xunil/wave_light_lp5569/wave_light_lp5569.png

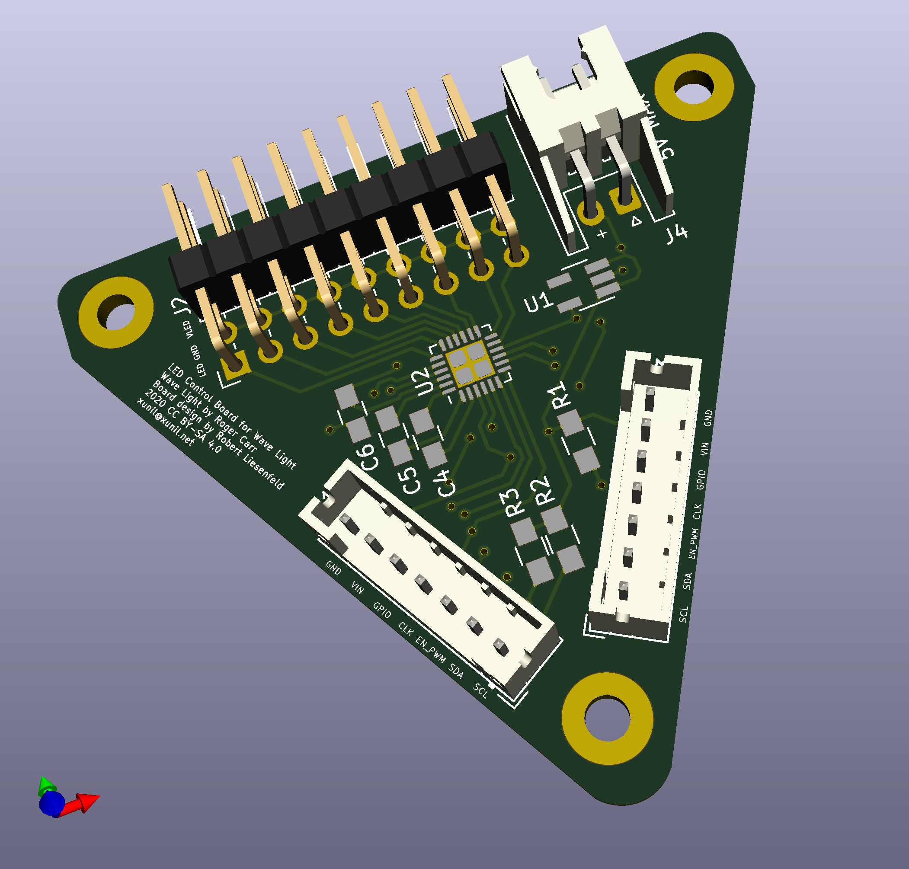
wave_light_lp5569.png
