xunil/wave_light_lp5569/wave_light_lp5569.pdf

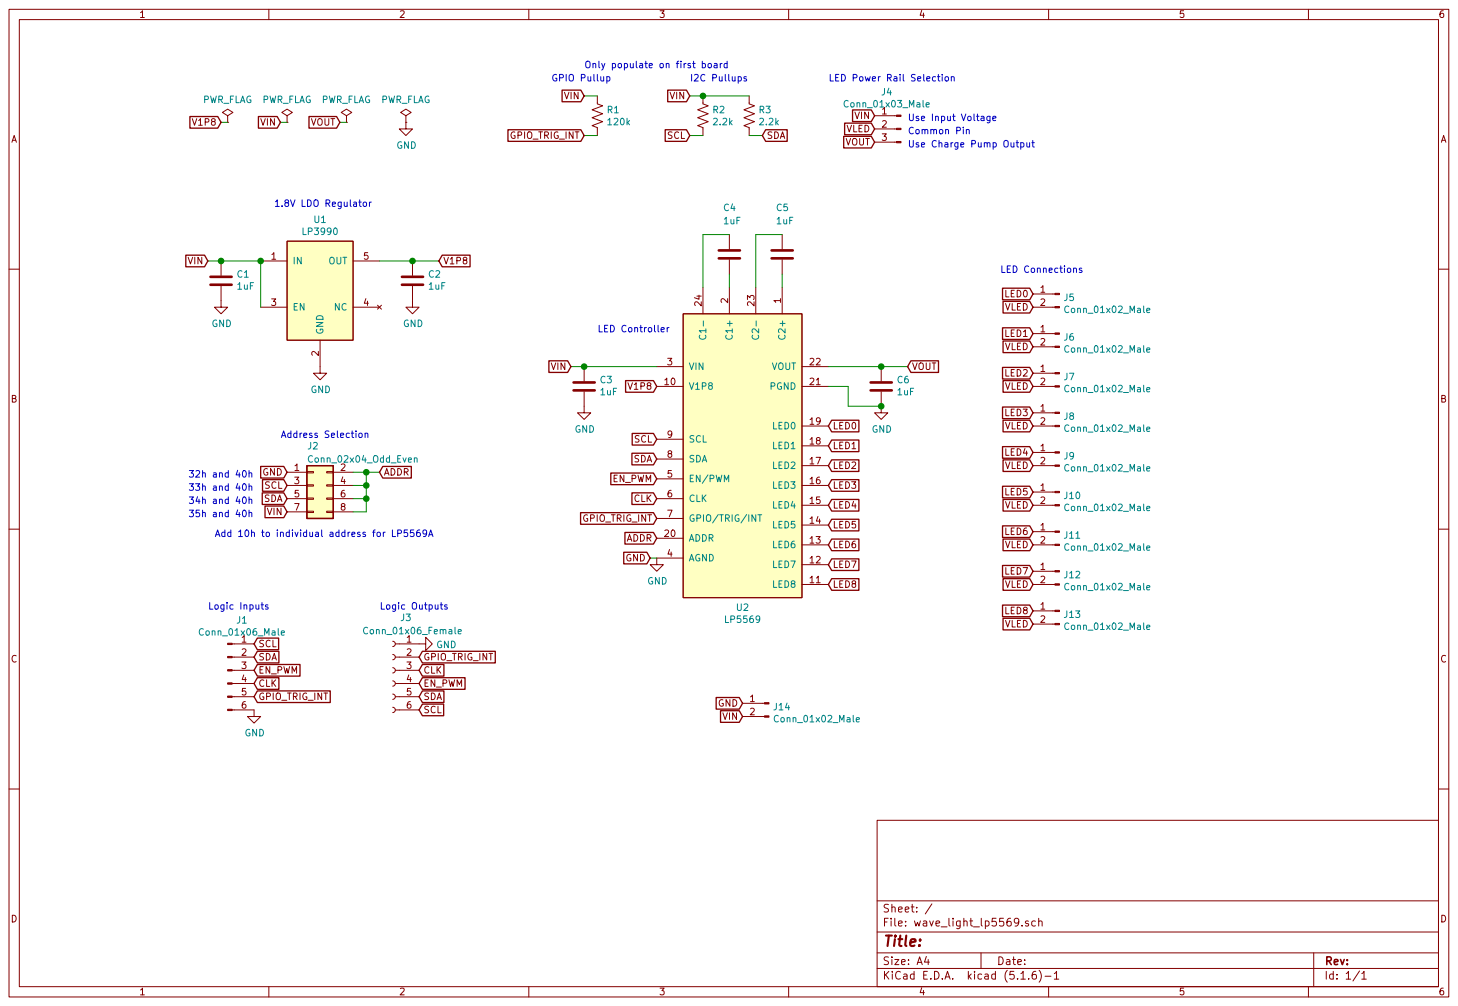
[picture p2: page 1]

1.8V LDO Regulator Address Selection

VOUT VIN
Use Charge Pump Output LED Controller 35h and 40h

Common Pin Use Input Voltage

2 ADDR 20 PGND 21 VOUT 22 C2- 23 C1- 24 VIN 3 AGND 4 EN/PWM 5 CLK 6 GPIO/TRIG/INT 7 SDA 8 SCL 9 U2
