xunil/wave_light_lp5569/wave_light_lp5569.kicad_pcb

## KiCad design wave_light_lp5569.kicad_pcb (2021-01-07)

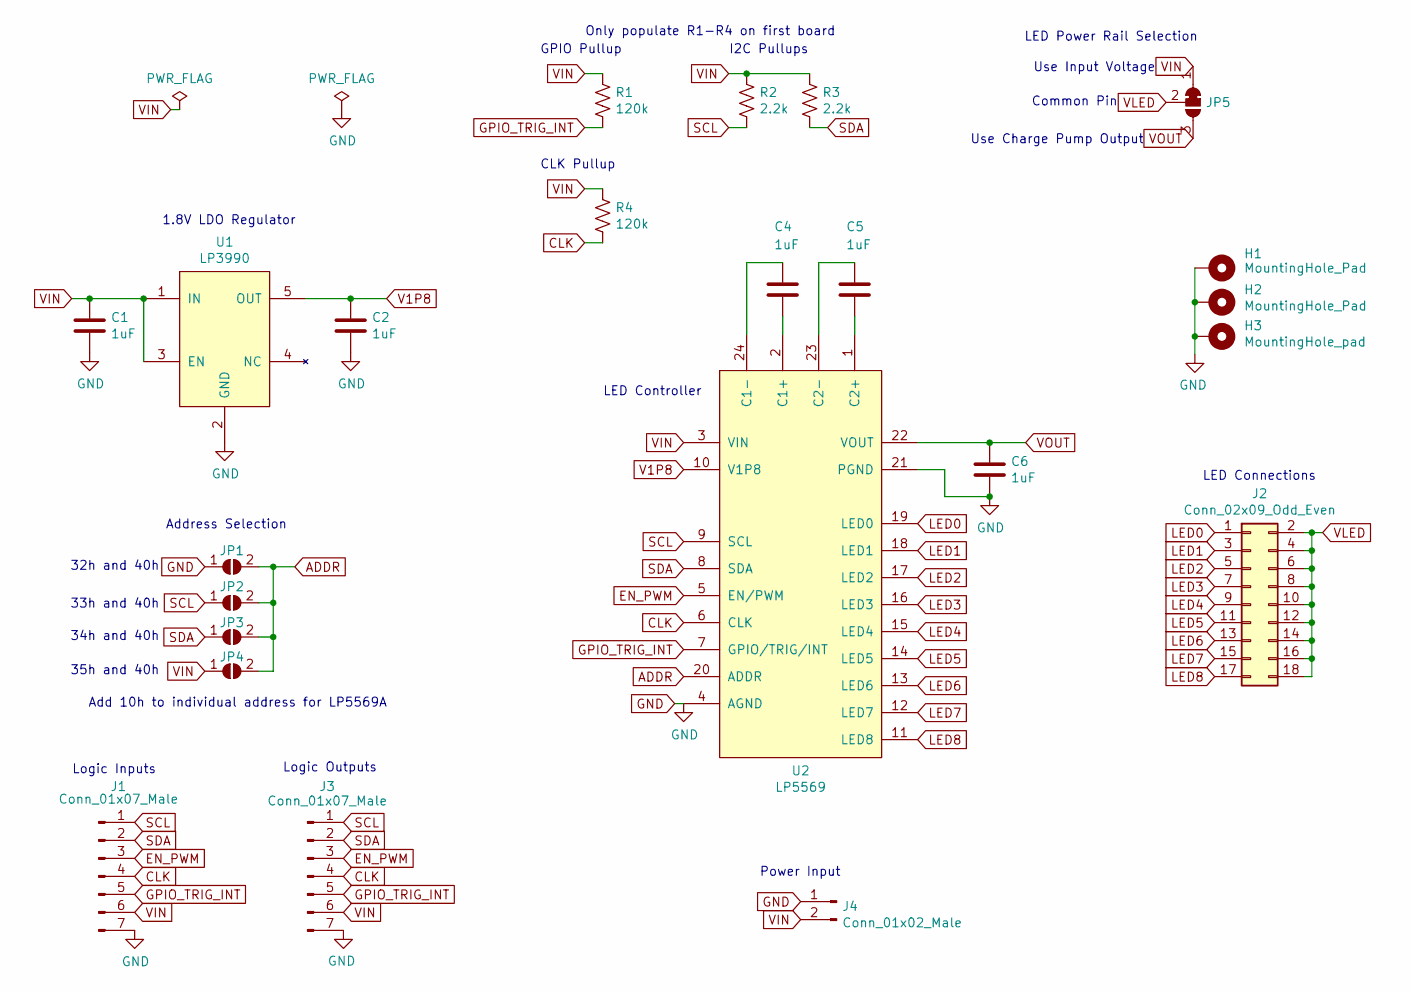
[picture p3: schematic wave_light_lp5569.sch]

Parts:
C1, C2, C4, C5, C6: 1uF; C_0805_2012Metric
H1, H2: MountingHole_Pad; MountingHole_2.7mm_Pad
H3: MountingHole_pad; MountingHole_2.7mm_Pad
J1, J3: Conn_01x07_Male; JST_PH_B7B-PH-K_1x07_P2.00mm_Vertical
J2: Conn_02x09_Odd_Even; PinHeader_2x09_P2.54mm_Horizontal
J4: Conn_01x02_Male; JST_XH_S2B-XH-A_1x02_P2.50mm_Horizontal
JP1, JP2, JP3, JP4: SolderJumper_2_Open; SolderJumper-2_P1.3mm_Open_RoundedPad1.0x1.5mm
JP5: SolderJumper_3_Bridged12; SolderJumper-3_P1.3mm_Bridged12_RoundedPad1.0x1.5mm
R1, R4: 120k; R_0805_2012Metric
R2, R3: 2.2k; R_0805_2012Metric
U1: LP3990; SOT-23-5
U2: LP5569; WQFN-24-1EP_4x4mm_P0.5mm_EP2.6x2.6mm

Connections:
ADDR: JP1.2 (B), JP2.2 (B), JP3.2 (B), JP4.2 (B), U2.20 (ADDR)
CLK: J1.4, J3.4, R4.2, U2.6 (CLK)
EN_PWM: J1.3, J3.3, U2.5 (EN/PWM)
GND: C1.1, C2.1, C6.1, H1.1, H2.1, H3.1, J1.7, J3.7, J4.1, JP1.1 (A), U1.2 (GND), U2.4 (AGND), U2.21 (PGND)
GPIO_TRIG_INT: J1.5, J3.5, R1.2, U2.7 (GPIO/TRIG/INT)
LED0: J2.1, U2.19 (LED0)
LED1: J2.3, U2.18 (LED1)
LED2: J2.5, U2.17 (LED2)
LED3: J2.7, U2.16 (LED3)
LED4: J2.9, U2.15 (LED4)
LED5: J2.11, U2.14 (LED5)
LED6: J2.13, U2.13 (LED6)
LED7: J2.15, U2.12 (LED7)
LED8: J2.17, U2.11 (LED8)
unnamed: C4.1, U2.2 (C1+)
unnamed: C4.2, U2.24 (C1-)
unnamed: C5.1, U2.1 (C2+)
unnamed: C5.2, U2.23 (C2-)
SCL: J1.1, J3.1, JP2.1 (A), R2.2, U2.9 (SCL)
SDA: J1.2, J3.2, JP3.1 (A), R3.2, U2.8 (SDA)
V1P8: C2.2, U1.5 (OUT), U2.10 (V1P8)
VIN: C1.2, J1.6, J3.6, J4.2, JP4.1 (A), JP5.1 (A), R1.1, R2.1, R3.1, R4.1, U1.1 (IN), U1.3 (EN), U2.3 (VIN)
VLED: J2.2, J2.4, J2.6, J2.8, J2.10, J2.12, J2.14, J2.16, J2.18, JP5.2 (C)
VOUT: C6.2, JP5.3 (B), U2.22 (VOUT)

Notes on the sheet:
1.8V LDO Regulator
Address Selection
Logic Inputs
LED Power Rail Selection
LED Connections
Logic Outputs
I2C Pullups
GPIO Pullup
Only populate R1-R4 on first board
32h and 40h
33h and 40h
34h and 40h
35h and 40h
Add 10h to individual address for LP5569A
LED Controller
Use Charge Pump Output
Use Input Voltage
Common Pin
Power Input
CLK Pullup

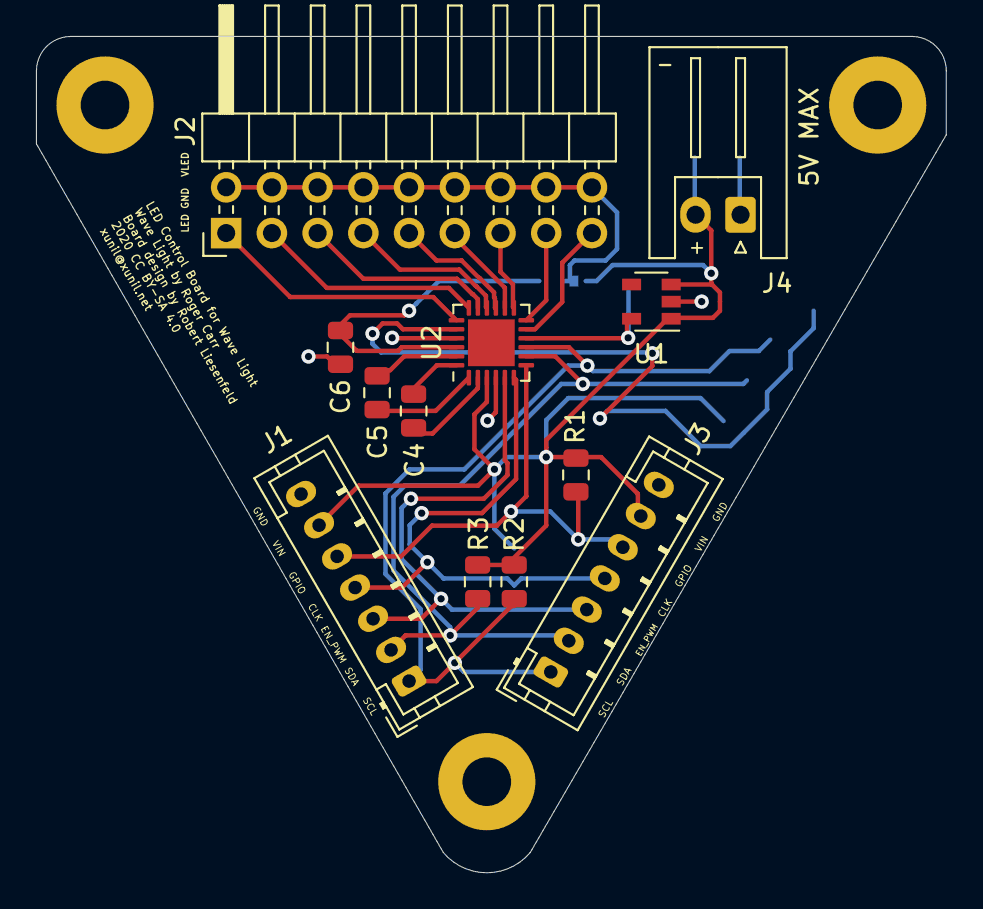
[picture p4: board wave_light_lp5569.kicad_pcb from above]

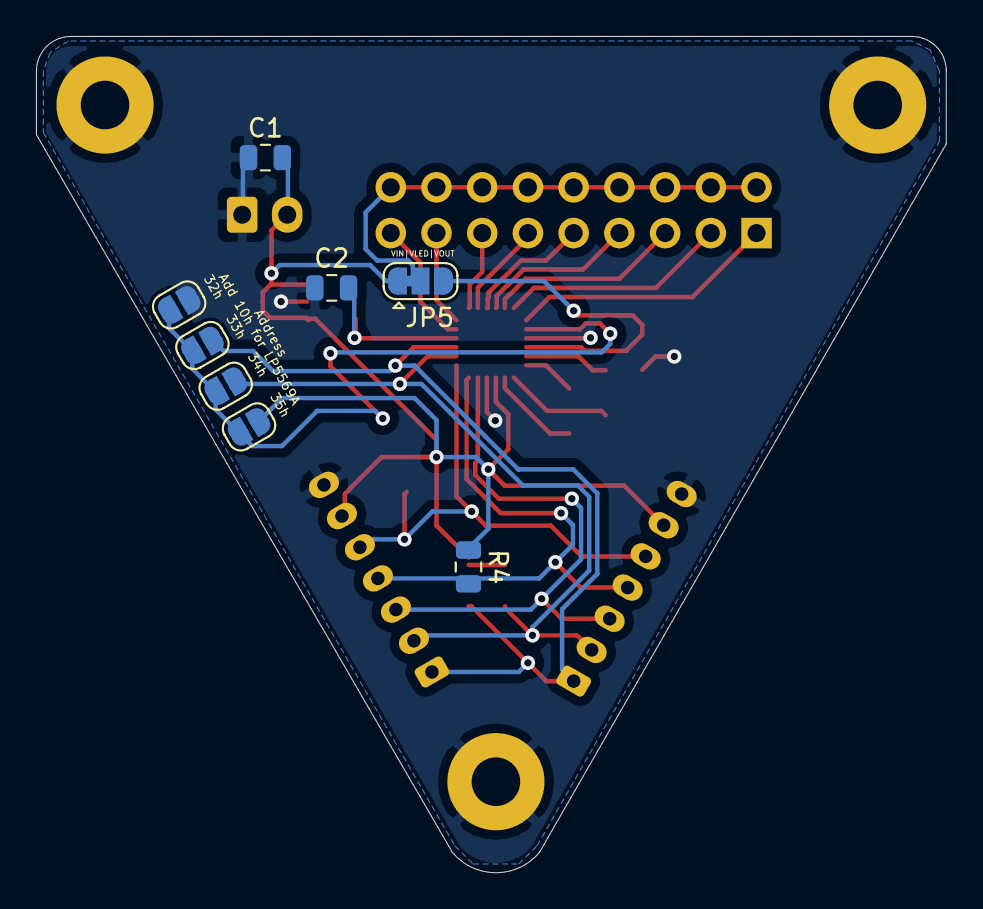
[picture p5: board wave_light_lp5569.kicad_pcb from below]

Board: 2 copper layers, 50.5 x 46.5 mm, 23 parts (8 on the bottom side), 24 nets.
