xunil/wave_light_lp5569/constants.py

# GPIO pin numbers
EN_PWM_GPIO_PIN = 4

# Registers
CONFIG = 0x0
LED_ENGINE_CONTROL1 = 0x1
LED_ENGINE_CONTROL2 = 0x2
LED0_CONTROL = 0x7
LED1_CONTROL = 0x8
LED2_CONTROL = 0x9
LED3_CONTROL = 0xA
LED4_CONTROL = 0xB
LED5_CONTROL = 0xC
LED6_CONTROL = 0xD
LED7_CONTROL = 0xE
LED8_CONTROL = 0xF
LED0_PWM = 0x16
LED1_PWM = 0x17
LED2_PWM = 0x18
LED3_PWM = 0x19
LED4_PWM = 0x1A
LED5_PWM = 0x1B
LED6_PWM = 0x1C
LED7_PWM = 0x1D
LED8_PWM = 0x1E
LED0_CURRENT = 0x22
LED1_CURRENT = 0x23
LED2_CURRENT = 0x24
LED3_CURRENT = 0x25
LED4_CURRENT = 0x26
LED5_CURRENT = 0x27
LED6_CURRENT = 0x28
LED7_CURRENT = 0x29
LED8_CURRENT = 0x2A
MISC = 0x2F
ENGINE1_PC = 0x30
ENGINE2_PC = 0x31
ENGINE3_PC = 0x32
MISC2 = 0x33
ENGINE_STATUS = 0x3C
IO_CONTROL = 0x3D
VARIABLE_D = 0x3E
RESET = 0x3F
ENGINE1_VARIABLE_A = 0x42
ENGINE2_VARIABLE_A = 0x43
ENGINE3_VARIABLE_A = 0x44
MASTER_FADER1 = 0x46
MASTER_FADER2 = 0x47
MASTER_FADER3 = 0x48
MASTER_FADER_PWM = 0x4A
ENGINE1_PROG_START = 0x4B
ENGINE2_PROG_START = 0x4C
ENGINE3_PROG_START = 0x4D
PROG_MEM_PAGE_SELECT = 0x4F
PROGRAM_MEM_00 = 0x50
ENGINE1_MAPPING1 = 0x70
ENGINE1_MAPPING2 = 0x71
ENGINE2_MAPPING1 = 0x72
ENGINE2_MAPPING2 = 0x73
ENGINE3_MAPPING1 = 0x74
ENGINE3_MAPPING2 = 0x75
PWM_CONFIG = 0x80
LED_FAULT1 = 0x81
LED_FAULT2 = 0x82
GENERAL_FAULT = 0x83

# LED control values
LEDCTL_EXTERNAL_POWER = 1 << 2
LEDCTL_EXPONENTIAL_ADJ = 1 << 3
LEDCTL_RATIOMETRIC_DIM = 1 << 4
LEDCTL_FADER_NONE = 0
LEDCTL_FADER_1 = 1 << 5
LEDCTL_FADER_2 = 2 << 5
LEDCTL_FADER_3 = 3 << 5
LEDCTL_FADER_PWMPIN = 5 << 5

# Engine modes
ENGINE_DISABLED = 0b00
ENGINE_LOAD_PROGRAM = 0b01
ENGINE_RUN_PROGRAM = 0b10
ENGINE_HALT = 0b11

RUNMODE_HOLD = 0b00
RUNMODE_STEP = 0b01
RUNMODE_FREE = 0b10
RUNMODE_ONCE = 0b11
