xunil/wave_light_lp5569/(commit log)

2020-06-23 New LED control board for the wave light based around the LP5569
    [wave_light_lp5569.kicad_pcb, wave_light_lp5569.sch]
2020-08-05 Initial checkin of Python code for testing LP5569 board
2020-08-17 Schematic PDF
2020-12-05 First go at a wedge-shaped board
    [wave_light_lp5569.kicad_pcb, wave_light_lp5569.sch]
2020-12-05 Attempting to have clock signal output on clock pin
2020-12-05 Attempting to get the clock pin to output internal clock
2020-12-16 Checkpointing work on the wedge board
    [wave_light_lp5569.kicad_pcb, wave_light_lp5569.sch]
2020-12-24 Skeleton of Forth cross-assembler for LP5569 execution engines
2020-12-26 Finally passing ERC and DRC, seems ready to send off for fab
    [wave_light_lp5569.kicad_pcb, wave_light_lp5569.sch]
2020-12-26 Adding board render
2021-01-07 Final version, sent to fab
    [wave_light_lp5569.kicad_pcb, wave_light_lp5569.sch]
2021-04-23 Added some abstraction about the object's I2C address to allow for multiple wave light boards
