xunil/wave_light_lp5569/(notices)

Notices in the files:
wave_light_lp5569.kicad_pcb:
2020 CC BY-SA 4.0
